deepdoo/OscilloClock/OscilloClock_51/Oscilloscope connection method.docx

Signal name | Drive board socket No | Pin no. of oscilloscope tube
| J2 VH6 pin socket | 3SJ1J | 8SJ31J | 7SJ32J | 5SJ38J
filament | 1 | 13 | 14 | 12 | 11
filament | 2 | 1 | 1 | 1 | 1
cathode | 3 | 2 | 2 | 2 | 2
Control grid | 4 | 3 | 3 | 3 | 10
Empty foot | 5
Focus anode A2 | 6 | 4 | 5 | 4 | 4
| J6 vh5 pin socket
First, sanyangji A1, A3 | 1 | 8 | 9 | 8 | 7
Horizontal deflection | 2 | 7 | 10 | 9 | 8
Horizontal deflection | 3 | 6 | 11 | 10 | 3
Vertical deflection | 4 | 9 | 8 | 7 | 6
Vertical deflection | 5 | 10 | 7 | 6 | 9

On the drive board, the 5-pin and 6-pin VH sockets are 1 pin near the transformer
