deepdoo/OscilloClock/OscilloClock_51/fw/sc_demo_src/sc_demo/v10/trigonometric.h

/*
 * Trigonometric table
 */

#ifndef _TRIGONOMETRIC_H_
#define _TRIGONOMETRIC_H_

/* sin(x)*100, cos(x)*100 */
int code trigonometric_table[] = {
	0, 100,
	1, 99,
	3, 99,
	5, 99,
	6, 99,
	8, 99,
	10, 99,
	12, 99,
	13, 99,
	15, 98,
	17, 98,
	19, 98,
	20, 97,
	22, 97,
	24, 97,
	25, 96,
	27, 96,
	29, 95,
	30, 95,
	32, 94,
	34, 93,
	35, 93,
	37, 92,
	39, 92,
	40, 91,
	42, 90,
	43, 89,
	45, 89,
	46, 88,
	48, 87,
	50, 86,
	51, 85,
	52, 84,
	54, 83,
	55, 82,
	57, 81,
	58, 80,
	60, 79,
	61, 78,
	62, 77,
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
};
#endif
